gmalysa/ece4760-acoustic-modem/report/software_diagrams.docx

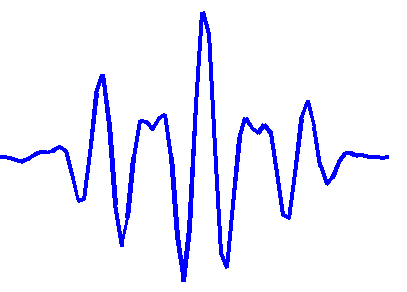
[picture p18: figure]

7.2 kHz | 0 | 1 | 1 | 0 | 1 | 0 | 0S
6.0 kHz | 1S | 0 | 1 | 1 | 0 | 0 | 1 | 1 | 0 | 0S
4.8 kHz | 0 | 0 | 1 | 1 | 0 | 1 | 0 | 0S

| | Samples
| | 0 | 1 | 2-61 | 62 | 63
Bit Pattern | 0 0 0 | 128 | 127 | … | 126 | 128
| … | … | … | … | … | …
| 0 1 0 | 128 | 126 | … | 127 | 128
| 0 1 1 | 128 | 127 | … | 125 | 128
| 1 0 0 | 128 | 126 | … | 127 | 128

PORT C

DAC

64 Samples @ 40 kHz

Advances every 1.6ms (64 samples)

ISR @ 40 kHz

Frequency Table

Serial

Scheduler

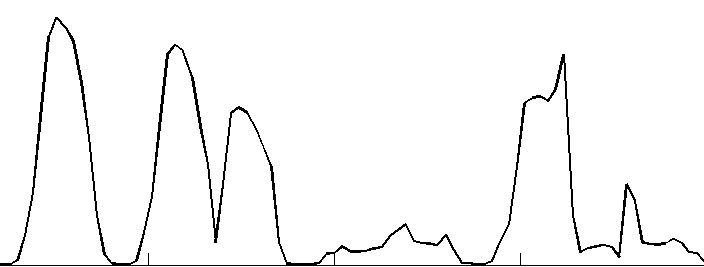
[picture p19: figure]

ISR @ 40 kHz

128 | 45 | 172 | 13 | 205 | 36

ADC

Sampled @ 40 kHz

Input Buffer

Resampled @ 40 kHz / f

sin² + cos²

Thresholding and pulse detection

Serial

One detection block per frequency f
