gmalysa/ece4760-acoustic-modem/report/transfer rates.xlsx

Data Bytes | Data + Protocol Bytes | Total Attempted Bytes | Byte delay | Total Time | Good Throughput | Good + Protocol Throughput | Transmitted Bytes | Percent Successful Packets
496 | 744 | 5184 | 10 | 99 | 5.01010101 | 7.515151515 | 52.36363636 | 0.1435185185
1040 | 1560 | 2670 | 12 | 56 | 18.57142857 | 27.85714286 | 47.67857143 | 0.5842696629
1040 | 1560 | 2370 | 14 | 55 | 18.90909091 | 28.36363636 | 43.09090909 | 0.6582278481
1032 | 1548 | 2442 | 15 | 59 | 17.49152542 | 26.23728814 | 41.38983051 | 0.6339066339
1040 | 1560 | 2382 | 16 | 59 | 17.62711864 | 26.44067797 | 40.37288136 | 0.6549118388
1032 | 1548 | 2334 | 17 | 60 | 17.2 | 25.8 | 38.9 | 0.6632390746
1024 | 1536 | 2424 | 18 | 63 | 16.25396825 | 24.38095238 | 38.47619048 | 0.6336633663
