gmalysa/ece4760-acoustic-modem/report/6_and_72.png

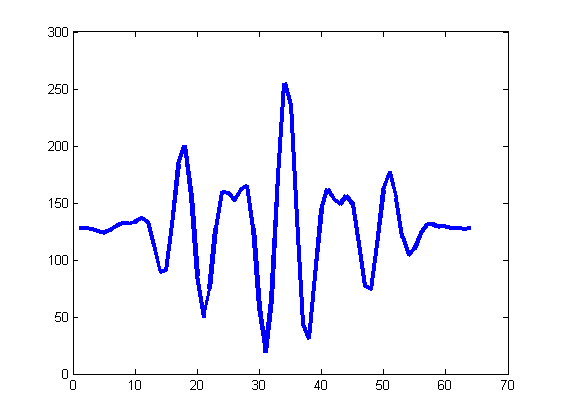
report/6_and_72.png
