gmalysa/ece4760-acoustic-modem/report/images/IMG_1063.png

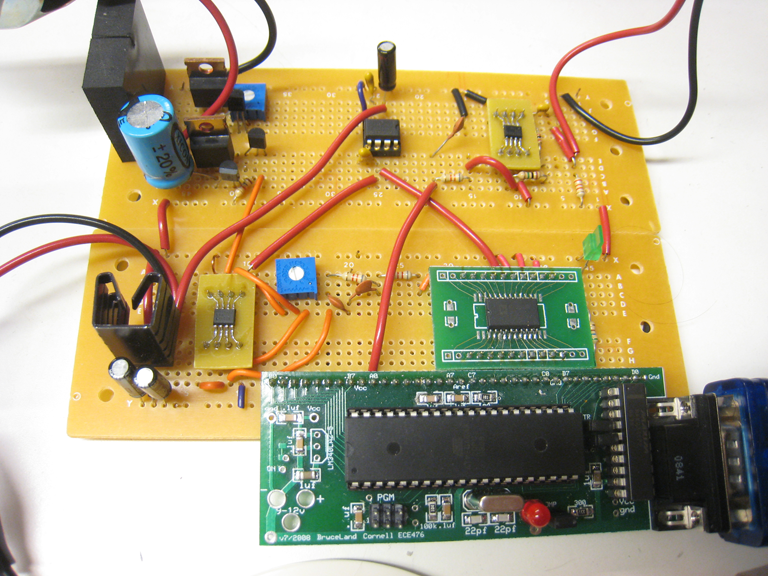
report/images/IMG_1063.png
