gmalysa/ece4760-acoustic-modem/report/images/IMG_1067.png

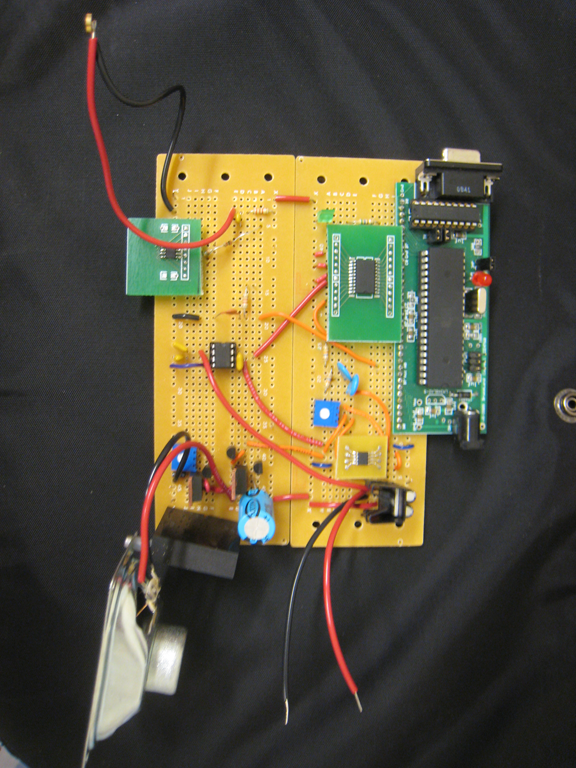
report/images/IMG_1067.png
