gmalysa/ece4760-acoustic-modem/report/images/IMG_1068.png

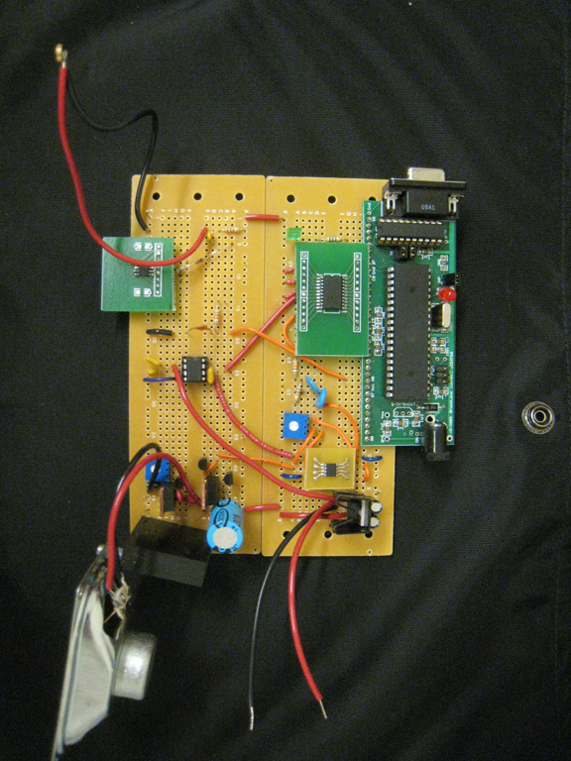
report/images/IMG_1068.png
