gmalysa/ece4760-acoustic-modem/report/images/IMG_1069.png

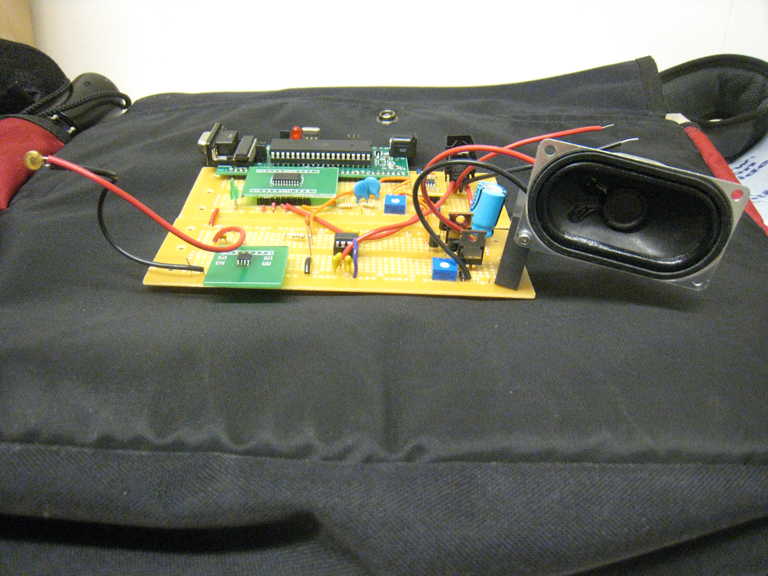
report/images/IMG_1069.png
