gmalysa/ece4760-acoustic-modem/report/images/IMG_1072.png

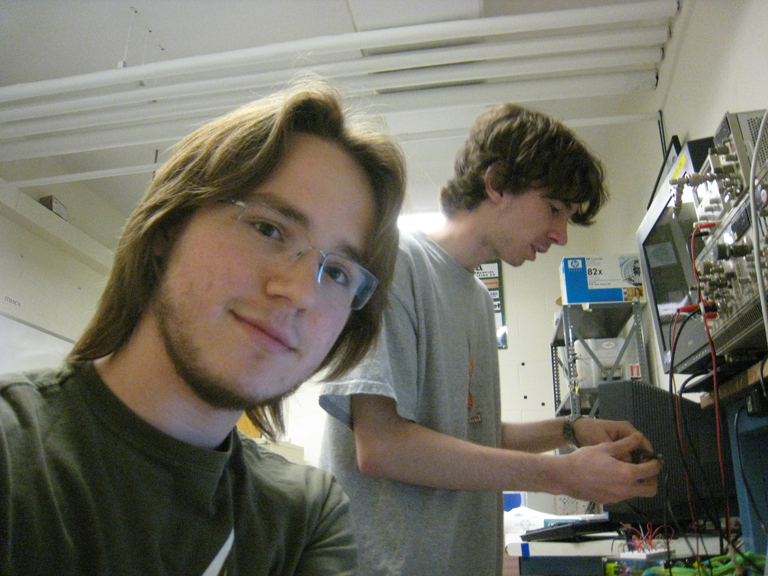
report/images/IMG_1072.png
