gmalysa/ece4760-acoustic-modem/report/images/IMG_1076.png

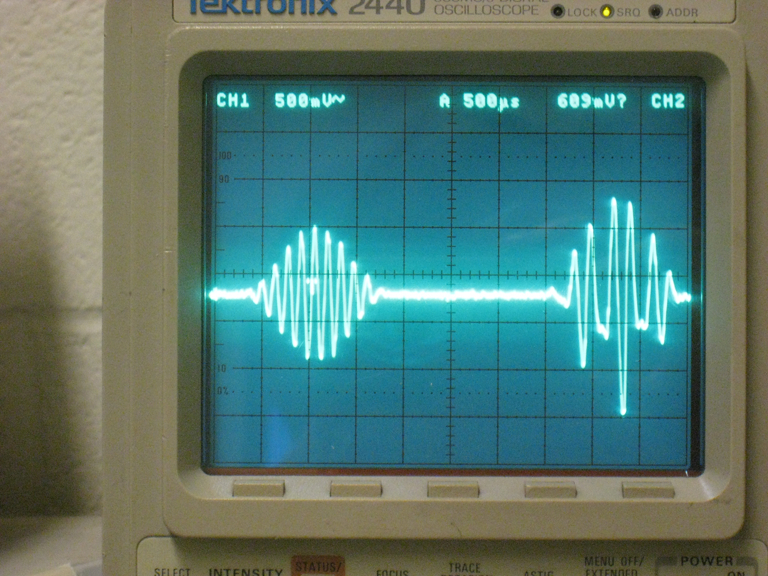
report/images/IMG_1076.png
