gmalysa/ece4760-acoustic-modem/report/images/IMG_1077.png

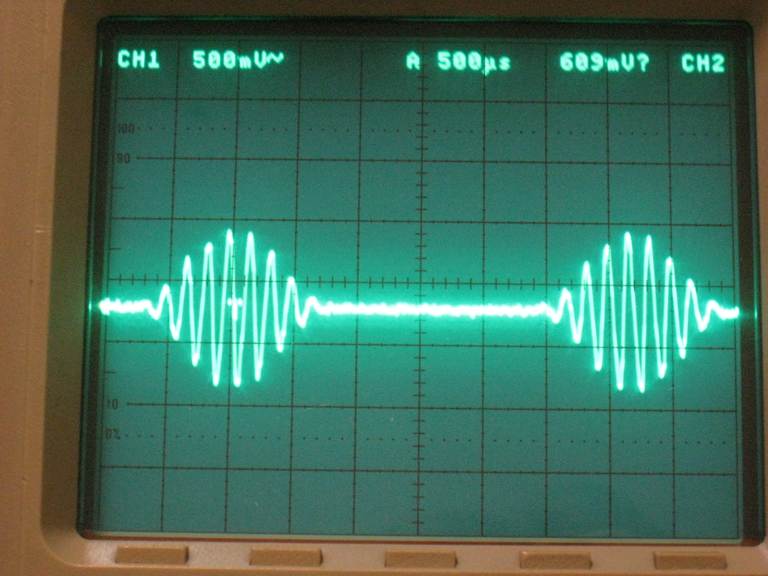
report/images/IMG_1077.png
