gmalysa/ece4760-acoustic-modem/report/images/IMG_1078.png

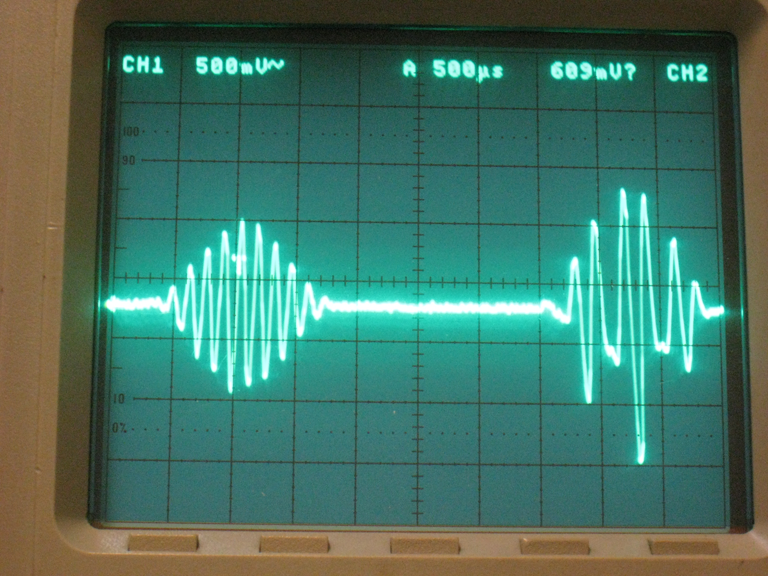
report/images/IMG_1078.png
