gmalysa/ece4760-acoustic-modem/report/images/IMG_1079.png

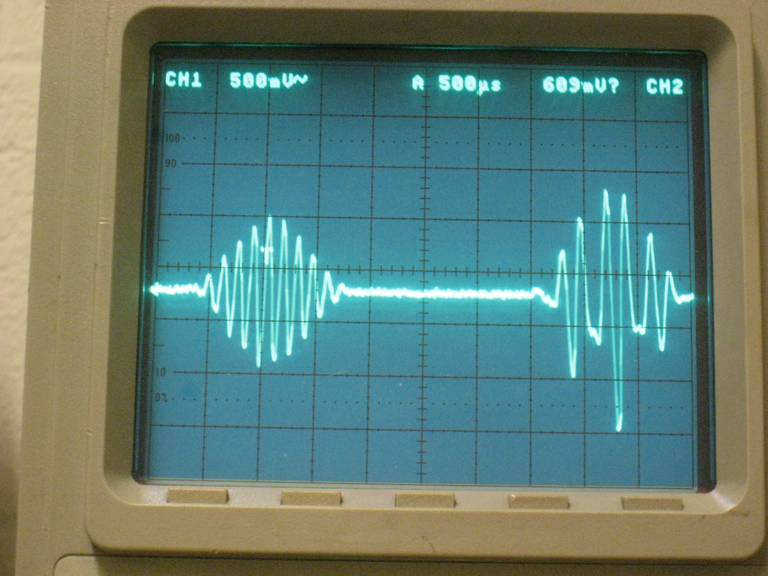
report/images/IMG_1079.png
