gmalysa/ece4760-acoustic-modem/report/images/IMG_1081.png

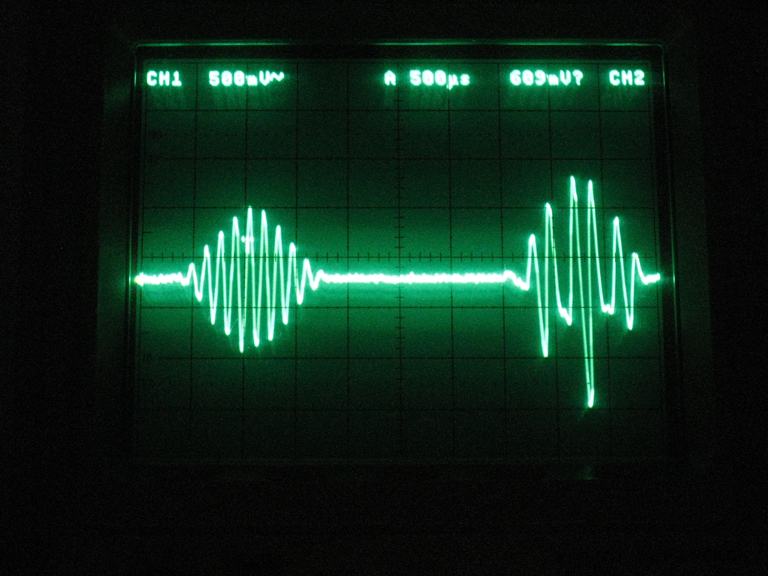
report/images/IMG_1081.png
