gmalysa/ece4760-acoustic-modem/report/sample_burst_clean.png

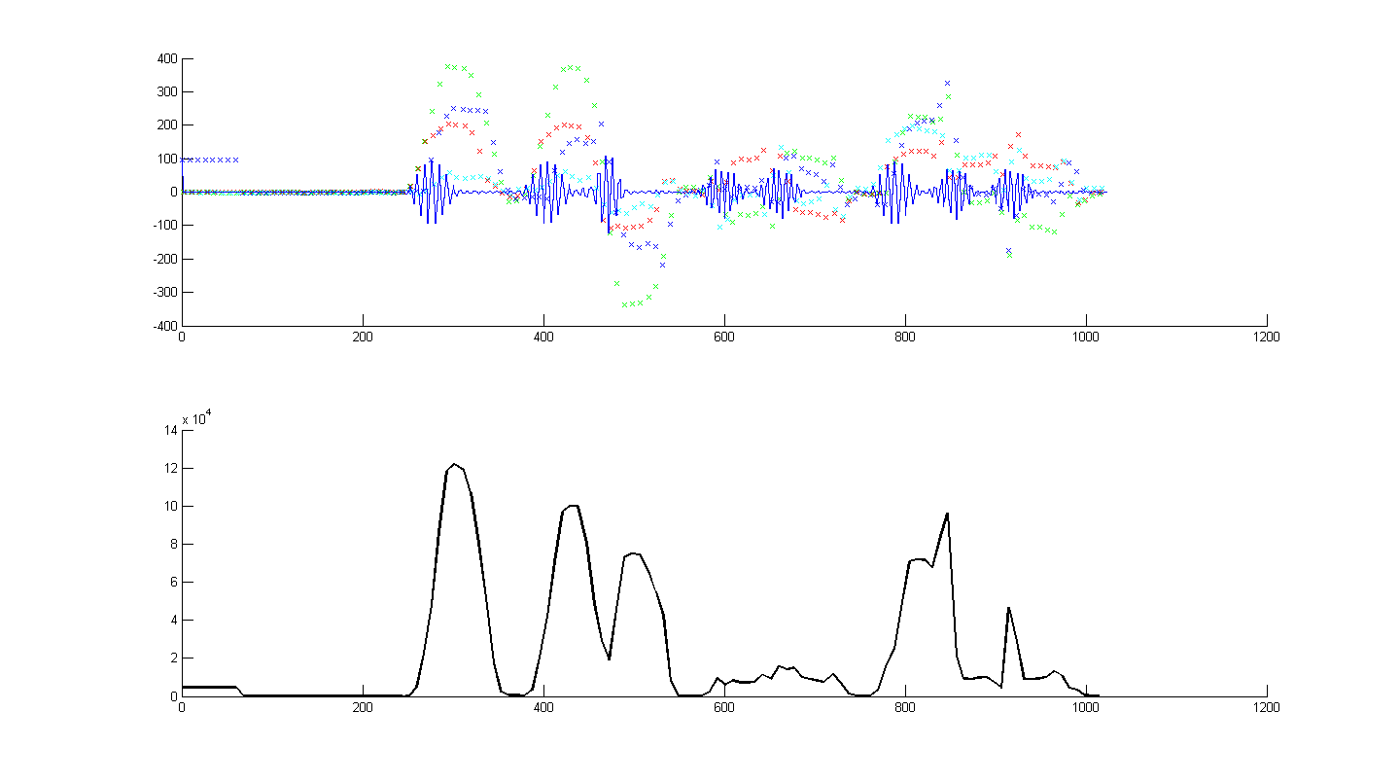
report/sample_burst_clean.png
