gmalysa/ece4760-acoustic-modem/schematics/circuit.asc

C1: cap; 1µF
C2: cap; 1µF
C3: cap; 22pF
C4: cap; 22pF
C5: cap; 1µF
C6: cap; 1µF
C7: cap; 1µF
C8: cap; 500pF
C9: cap; 500pF
C10: cap; 660µF
C11: cap; 2.2nF
C12: cap; 0.1µF
C13: cap; 0.1µF
C14: cap; 0.1µF
C15: cap; 0.1µF
C16: cap; 0.1µF
C17: cap; 1µF
C19: cap; 1nF
D1: LED; ""
D2: LED; ""
J1: njf; 2N5457
M1: nmos; AO6408
M2: nmos; AO6408
Q1: npn; 2N2222
Q2: npn; 2N2222
R1: res; 16k
R2: res; 16k
R3: res; 8
R4: res; 2200
R5: res; 300
R6: res; 100
R7: res; 100k
R8: res; 1000k
R9: res; 8k
R10: res; 560
R11: res; 2k
U1: ATMEGA644
U2: LM340T5
U3: AD7801
U4: MAX4282
U5: MAX6325
U6: max4282
U7: 
U8: max233
V1: voltage; 10
X1: xtal; ""
X2: trimpot
X3: trimpot
X5: pgm_hdr
Named nets: 0, Vcc, 10V, 2.5VB, 2.5V, IN, TX, RX
