gmalysa/ece4760-acoustic-modem/schematics/microphone_planned.asc

C1: cap; 0.000001
C2: cap; 500pF
C3: cap; 500pF
R1: res; 2200
R4: res; 1000
R5: res; 16k
R6: res; 10000
R7: res; 16k
U1: LT1797
V1: voltage; 5
V2: voltage; SINE(0 0.02 4000); AC 1
V3: voltage; 2.5
Named nets: 0
;tran 0.01
;noise v(n003) V2 dec 1000 1000 1000
.ac dec 100 3000 40000
