gmalysa/ece4760-acoustic-modem/sin_vals.c

#include "sin_vals.h"

uint8_t freqTable[256][64] PROGMEM = {
{128,128,128,128,128,128,128,128,128,128,128,128,128,128,128,128,128,128,128,128,128,128,128,128,128,128,128,128,128,128,128,128,128,128,128,128,128,128,128,128,128,128,128,128,128,128,128,128,128,128,128,128,128,128,128,128,128,128,128,128,128,128,128,128},
{128,128,128,126,123,122,126,135,144,147,136,114,94,88,107,144,179,190,165,113,62,42,69,134,200,231,205,134,56,15,35,106,189,238,227,162,81,28,31,85,157,207,211,171,113,71,63,90,131,162,169,154,129,111,106,113,125,133,134,131,128,127,127,128},
{128,128,127,126,125,128,132,135,130,120,113,117,134,150,149,128,101,93,115,152,173,156,112,77,83,127,175,185,147,90,64,90,147,188,178,127,78,71,110,160,181,157,113,85,93,127,157,159,137,112,104,116,133,141,137,128,121,122,126,129,129,128,127,128},
{128,128,127,125,123,123,129,138,142,136,123,110,107,115,128,140,146,149,147,135,112,85,72,94,148,205,221,176,89,16,11,83,188,255,240,153,56,11,42,120,189,209,179,128,91,85,101,123,137,142,141,138,133,125,119,117,121,128,132,132,129,127,127,128},
{128,128,127,126,127,131,133,127,117,117,133,148,141,112,96,117,156,168,130,83,84,138,186,168,99,58,97,174,200,142,66,60,132,199,183,104,55,89,164,194,147,83,74,124,172,165,119,89,105,141,155,138,114,110,125,137,135,127,123,125,128,128,128,128},
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
{128,128,127,126,126,125,128,137,133,120,127,138,118,102,127,144,130,142,163,119,73,115,154,110,97,168,186,133,122,119,46,38,173,255,179,102,98,74,62,143,201,146,103,140,149,102,97,130,130,122,145,150,122,111,127,130,123,126,130,129,128,128,128,128},
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
