gmalysa/ece4760-acoustic-modem/(commit log)

2010-04-11 Bunch of symbols + first bits of the schematic, including the entire output section (as implemented currently).
2010-04-12 integrated the new freqbuffer tables. This table has some invalid values (see issue 5).
    [sin_vals.c]
2010-04-12 Fixed the negative numbers problem.
    [sin_vals.c]
2010-04-12 Fixed sine table again.
    [sin_vals.c]
2010-04-15 First revision of the schematic is complete. Also updated the example matlab code.
2010-05-02 Yet another different detection scheme...this one requires looking at the resampling as an FIR filter and using time-domain detection based on the derivative and magnitude of the filter's output. It 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
2010-05-02 added my prototype code
2010-05-03 Works with arseney's broken code, changing it for my code.
    [sin_vals.c]
2010-05-04 Sample picture
2010-05-05 Final version of microcontroller code unless we notice something absolutely terrible before morning. Also, wrote a computer-side client that uses the acoustic modem as a physical layer and implements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
2010-05-05 schematic picture added
2010-05-05 More report info, updated communications program to list statistics about transmission. Fancy plots
    [transfer rates.xlsx]
2010-05-05 I think it's done, need commented code to be ready.
    [transfer rates.xlsx]
